Dogmans/h2-fan-duct/output/underside_down/air_path.png

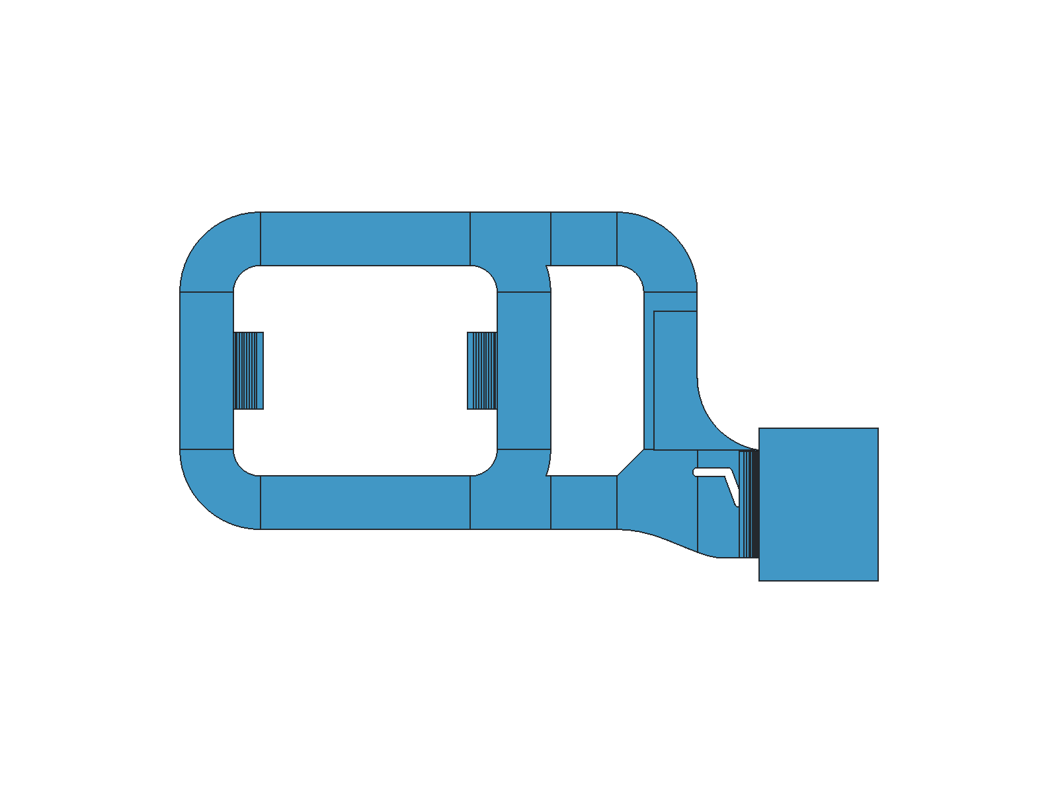
output/underside_down/air_path.png
