Dogmans/h2-fan-duct/output/underside_down/duct.png

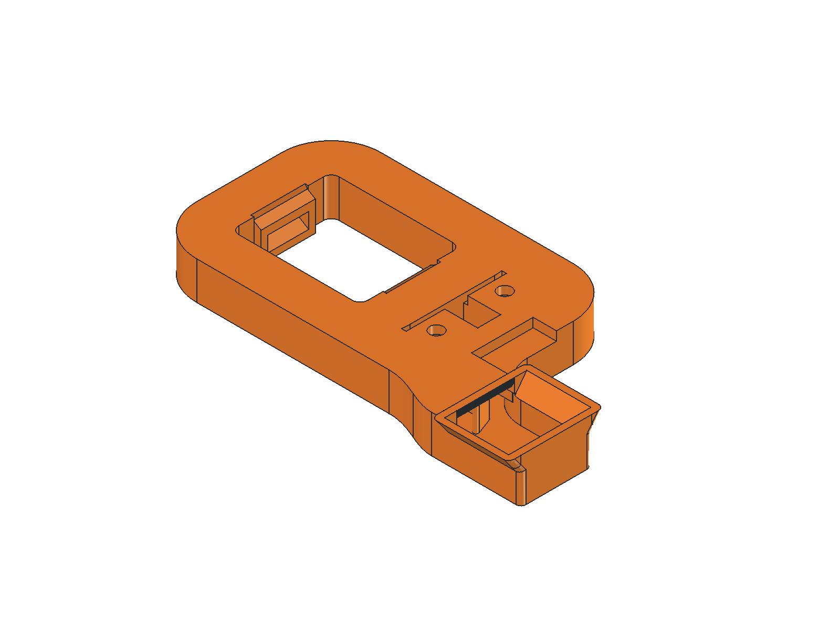
output/underside_down/duct.png
