Dogmans/h2-fan-duct/output/underside_down/duct_bottom.png

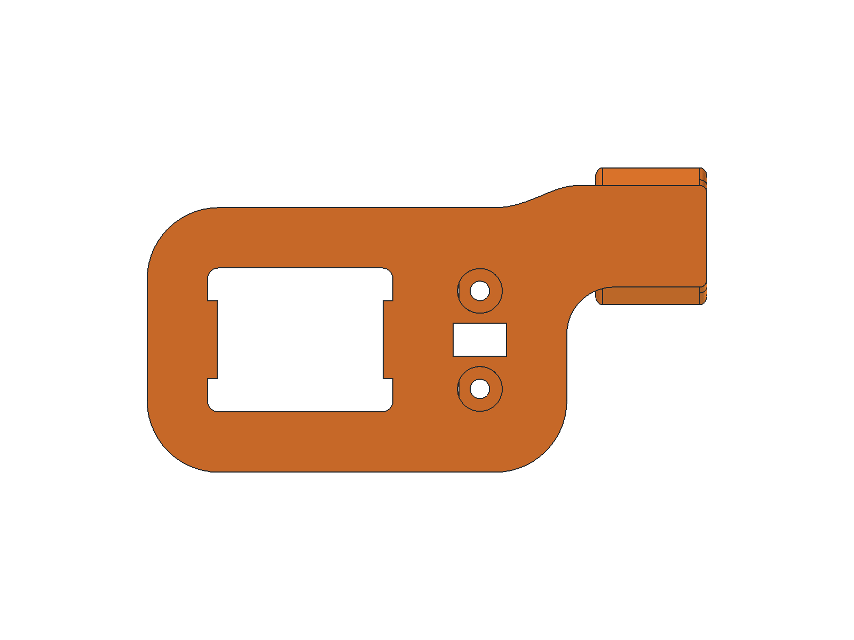
output/underside_down/duct_bottom.png
