Dogmans/h2-fan-duct/output/underside_down/intake_gap.png

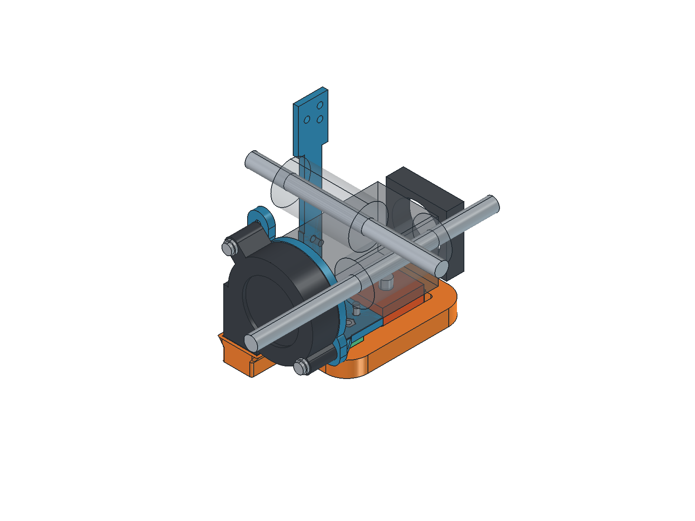
output/underside_down/intake_gap.png
