Dogmans/h2-fan-duct/output/underside_down/underside.png

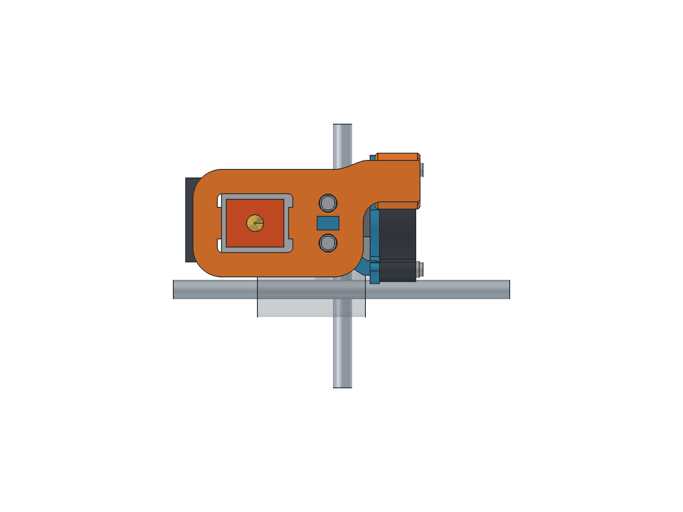
output/underside_down/underside.png
