Dogmans/h2-fan-duct/reference/5015-drawing.png

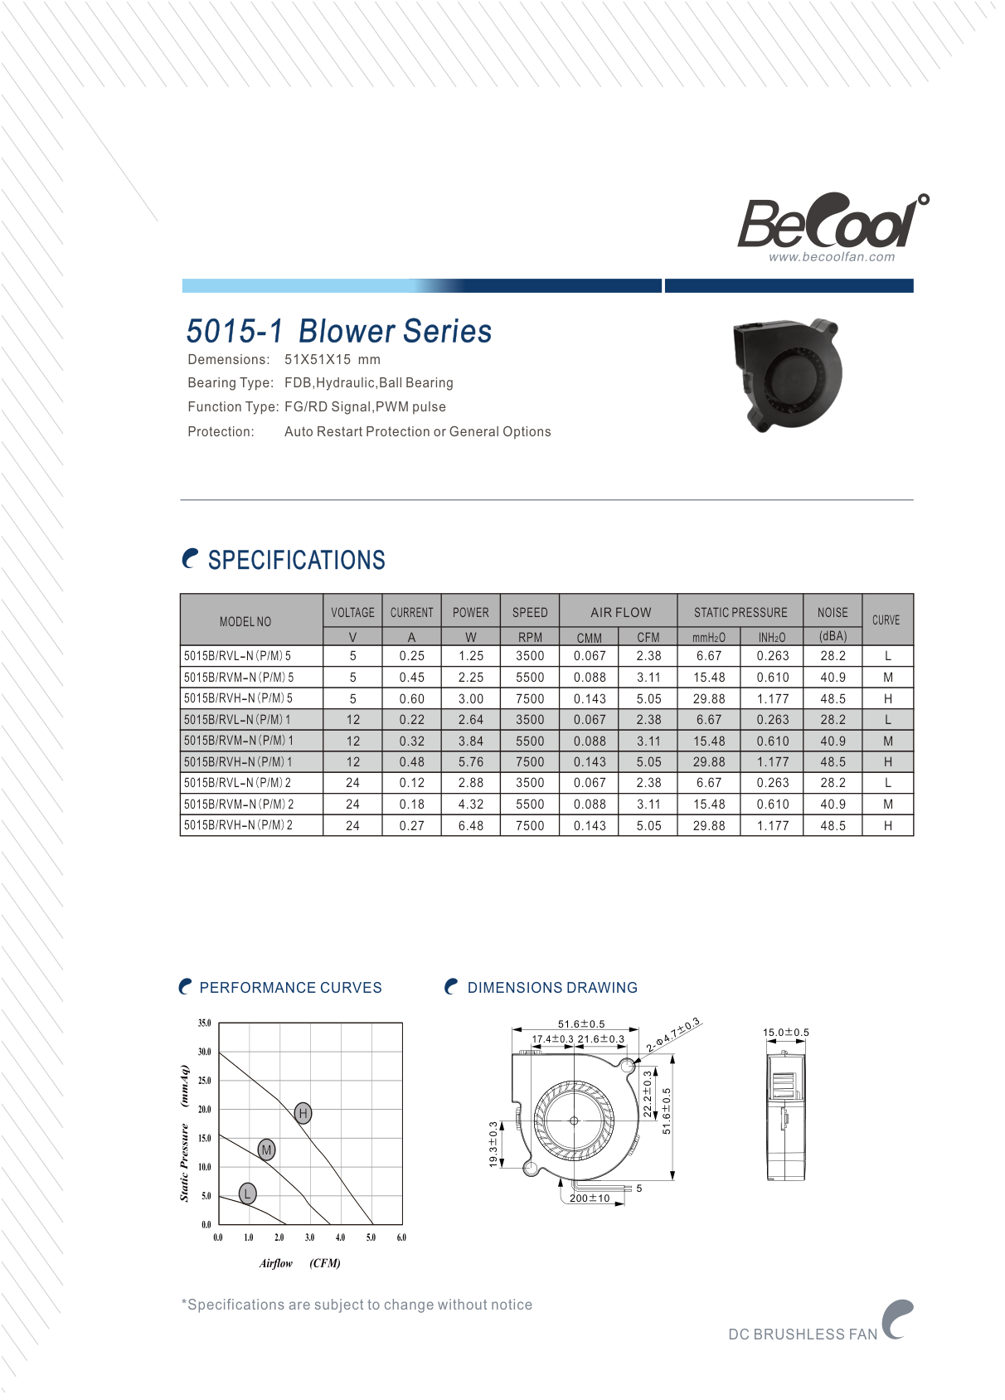
reference/5015-drawing.png
