Dogmans/h2-fan-duct/reference/H2-dimensions.png

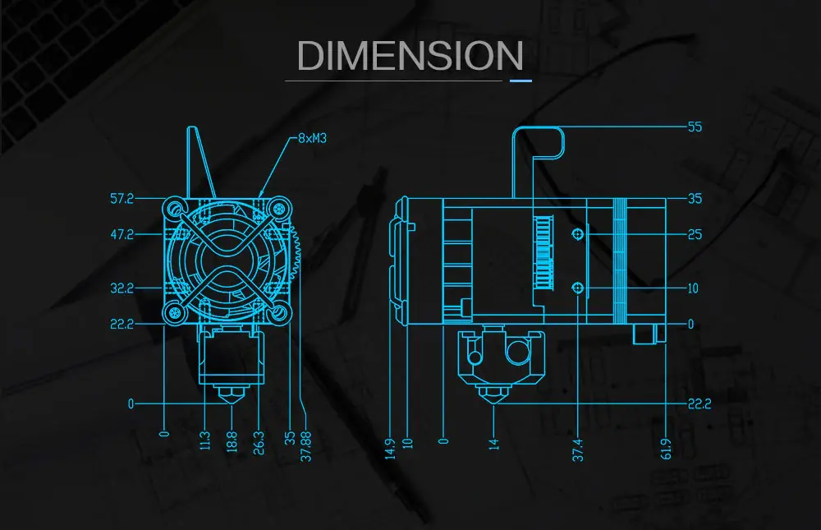
reference/H2-dimensions.png
