Dogmans/h2-fan-duct/reference/H2-page2.png

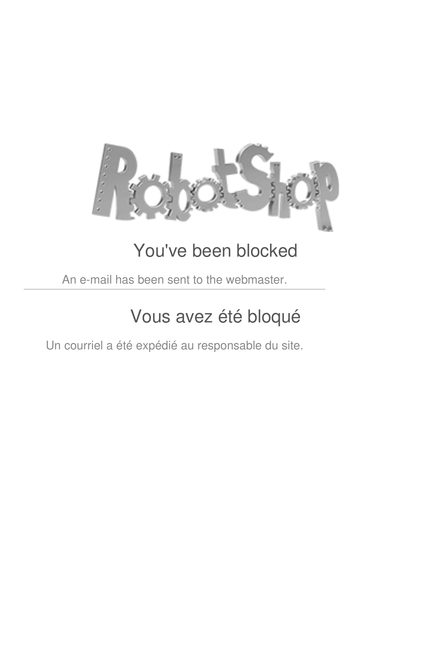
reference/H2-page2.png
