Dogmans/h2-fan-duct/reference/H2-v2-dimensions.jpg

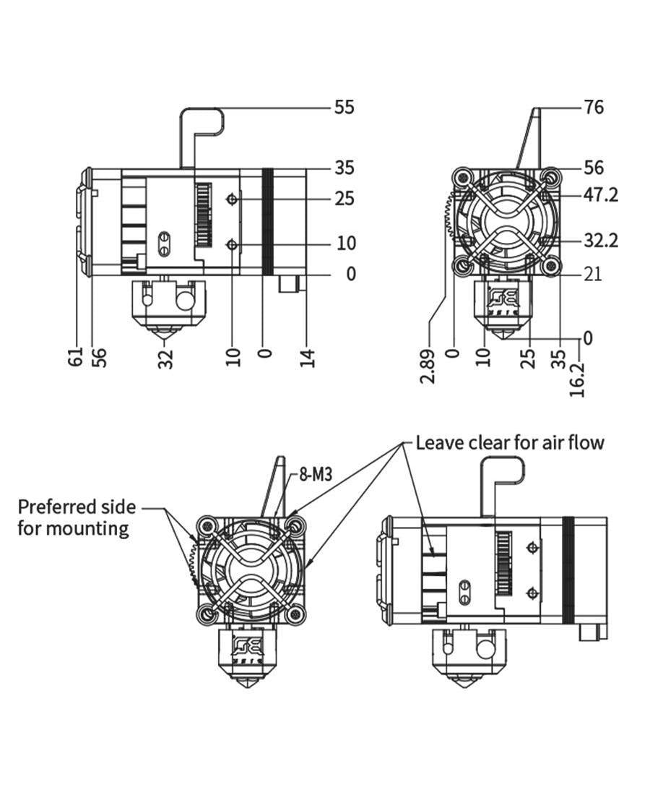
reference/H2-v2-dimensions.jpg
