Dogmans/h2-fan-duct/output/underside_down/duct_assembled.step

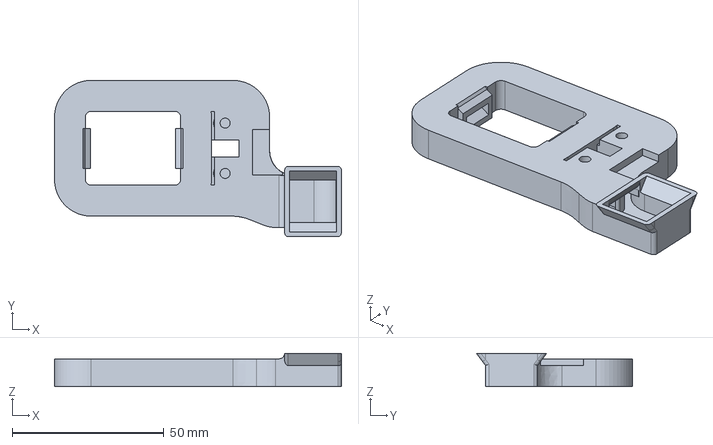
[picture p13: CAD file, 2026-11-11]
output/underside_down/duct_assembled.step
94.7 x 51.5 x 11.0 mm
