Dogmans/h2-fan-duct/output/before_clearance_redesign/duct_assembled.step

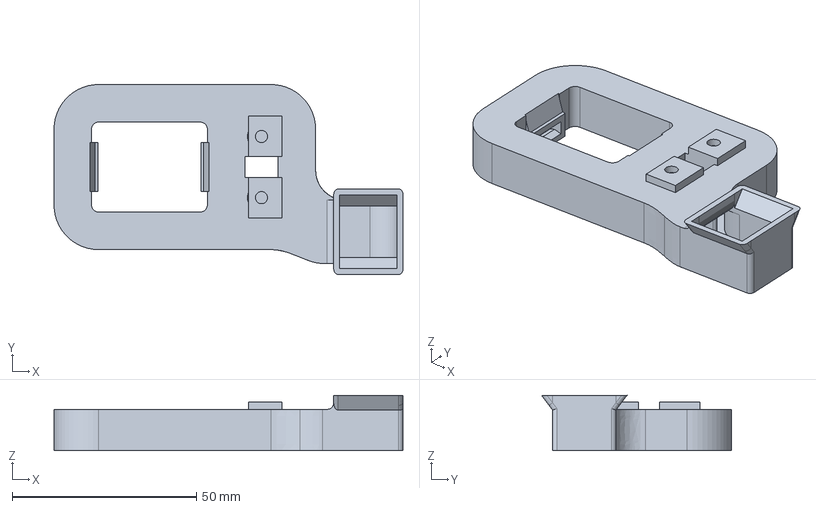
[picture p14: CAD file, 2026-11-08]
output/before_clearance_redesign/duct_assembled.step
94.7 x 51.5 x 15.0 mm
