Dogmans/h2-fan-duct/output/underside_down/printed_assembly.step

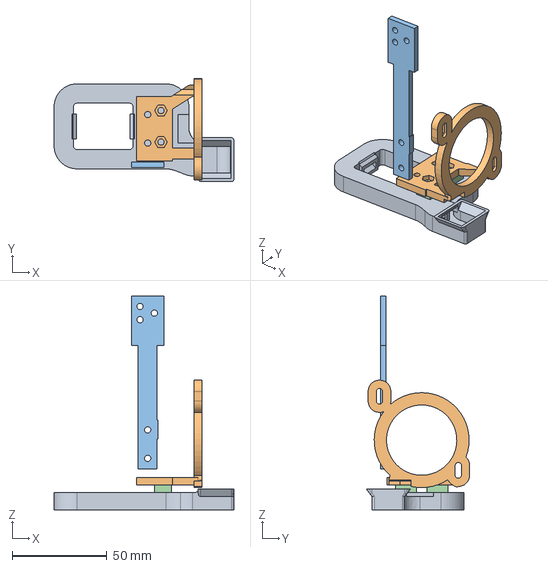
[picture p15: CAD file, 2026-11-11]
output/underside_down/printed_assembly.step
94.7 x 54.5 x 112.7 mm
