Dogmans/h2-fan-duct/output/underside_down/spacer_4mm_assembled.step

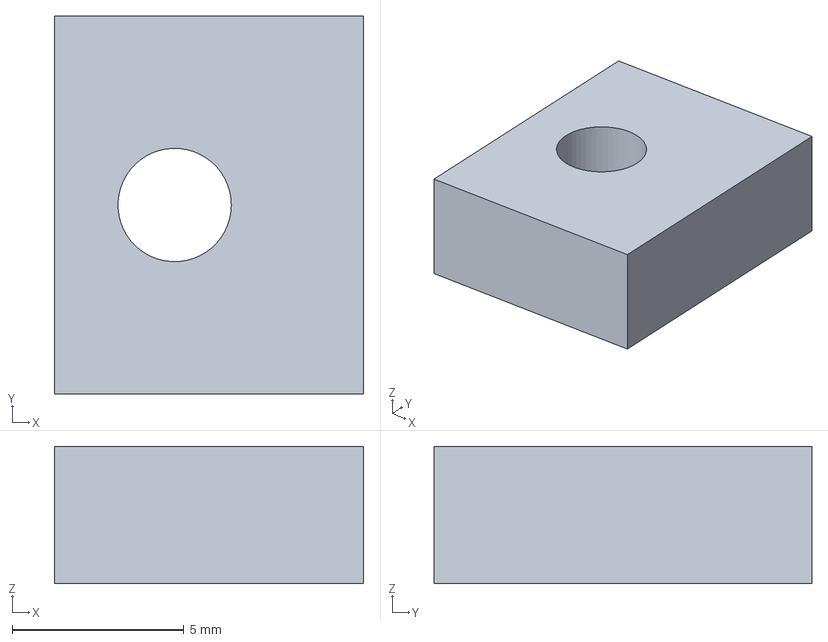
[picture p16: CAD file, 2026-11-08]
output/underside_down/spacer_4mm_assembled.step
9.00 x 11.0 x 4.00 mm
