Dogmans/h2-fan-duct/output/underside_down/chain_plate_assembled.step

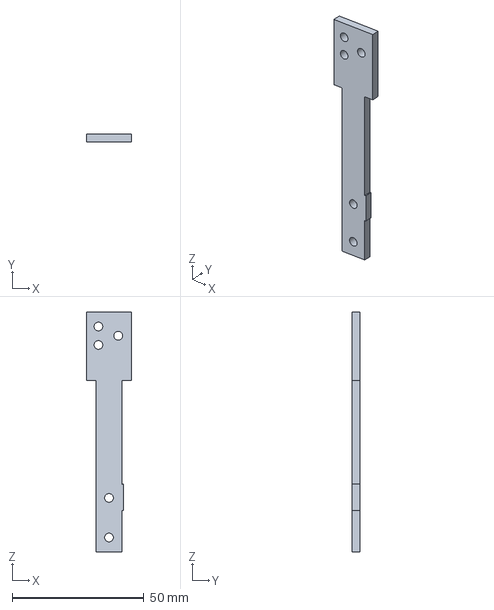
[picture p17: CAD file, 2026-11-08]
output/underside_down/chain_plate_assembled.step
17.0 x 3.00 x 91.0 mm
