Dogmans/h2-fan-duct/output/underside_down/spacer_2mm_assembled.step

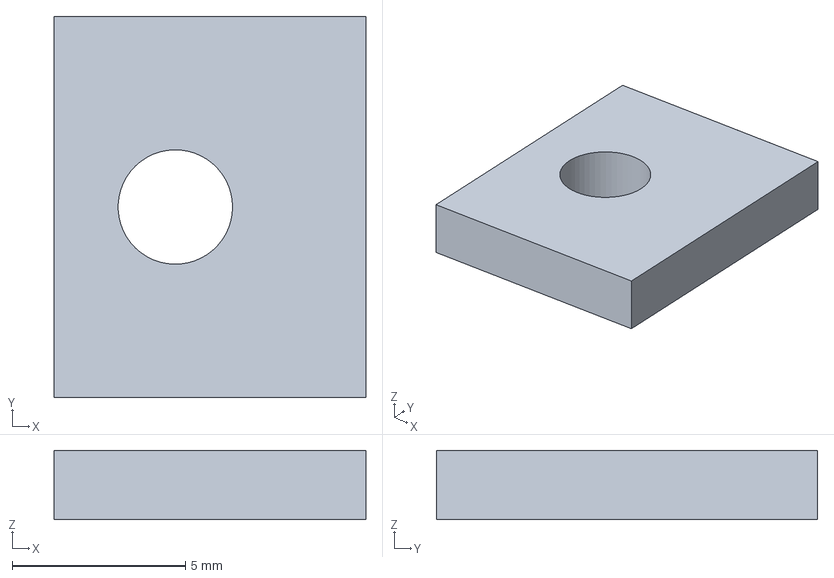
[picture p18: CAD file, 2026-11-08]
output/underside_down/spacer_2mm_assembled.step
9.00 x 11.0 x 2.00 mm
