Dogmans/h2-fan-duct/output/underside_down/fan_bracket_assembled.step

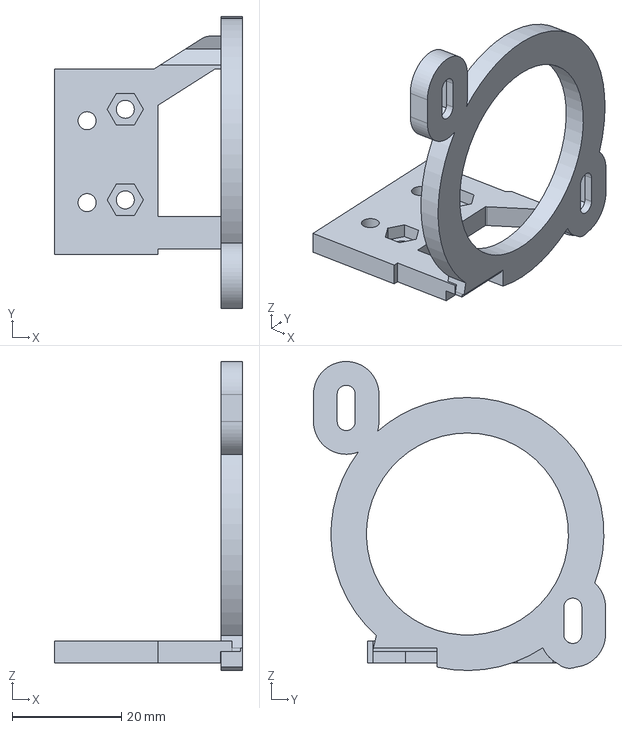
[picture p19: CAD file, 2026-11-08]
output/underside_down/fan_bracket_assembled.step
34.5 x 53.5 x 56.6 mm
