Dogmans/h2-fan-duct/output/before_clearance_redesign/H2_5015_Underside_Down.FCStd

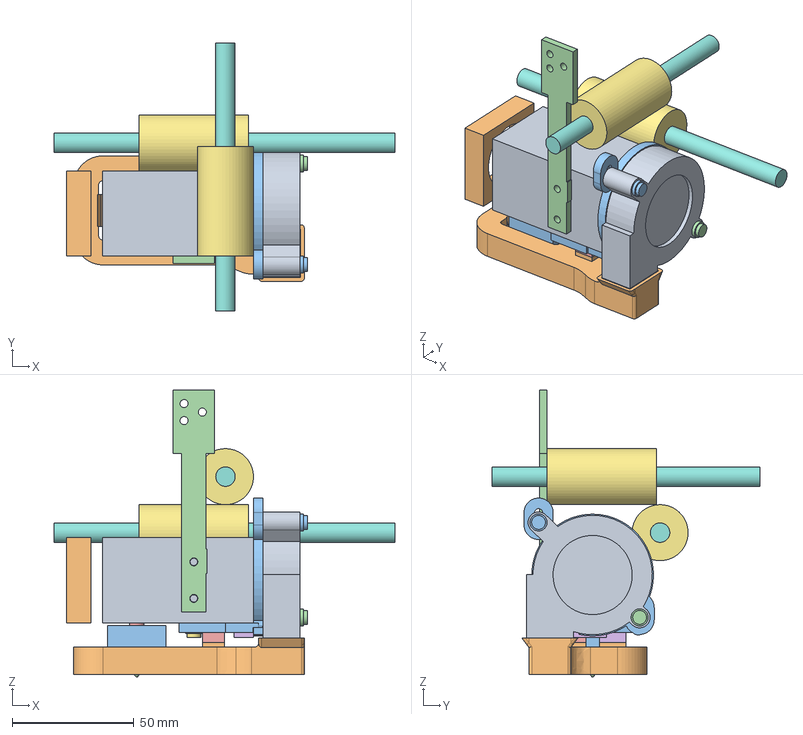
[picture p20: CAD file, 2026-11-11]
output/before_clearance_redesign/H2_5015_Underside_Down.FCStd
140.0 x 110.0 x 117.7 mm
H2 body and motor envelope
KEEP - stock 3510 heatsink cooling fan
Heater / sock keepout - approximate
Nozzle tip datum Z=0
Heatbreak simplified
Motor connector keepout - verify actual plug / wires
Carriage bearing envelopes - verify installed variant
8 mm rods inferred from bearing positions
BUY - 5015 intake outward, discharge down
PRINT - closed twin-feed O duct, underside attachment
PRINT - underside fan bracket, outward intake
PRINT - chain plate
PRINT - 4 mm spacer (nominal duct height)
PRINT - 4 mm spacer (nominal duct height)001
h2_1 - reference hardware
h2_2 - reference hardware
duct_1 - reference hardware
duct_2 - reference hardware
fan_1 - reference hardware
fan_2 - reference hardware
