Dogmans/h2-fan-duct/output/underside_down/fan_bracket_print.stl

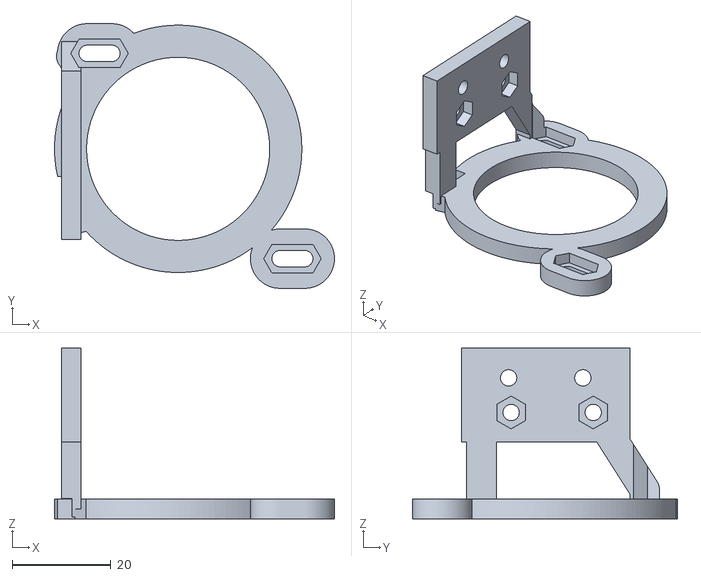
[picture p22: CAD file, 2026-11-08]
output/underside_down/fan_bracket_print.stl
56.6 x 53.5 x 34.5
