Dogmans/h2-fan-duct/(list of files, cad)

Other CAD files:
output/before_clearance_redesign/duct_print.stl
output/underside_down/H2_5015_Underside_Down-PRINT - 4 mm spacer (nominal duct height)001.stl
output/underside_down/H2_5015_Underside_Down-PRINT - underside fan bracket, outward intake.stl
output/underside_down/duct_print.stl
output/underside_down/H2_5015_Underside_Down-PRINT - 4 mm spacer (nominal duct height).stl
output/underside_down/H2_5015_Underside_Down-PRINT - closed twin-feed O duct, underside attachment.stl
output/underside_down/chain_plate_print.stl
output/underside_down/spacer_4mm_print.stl
output/underside_down/spacer_2mm_print.stl
