Dogmans/h2-fan-duct/output/underside_down/chain_plate_print_orientation.png

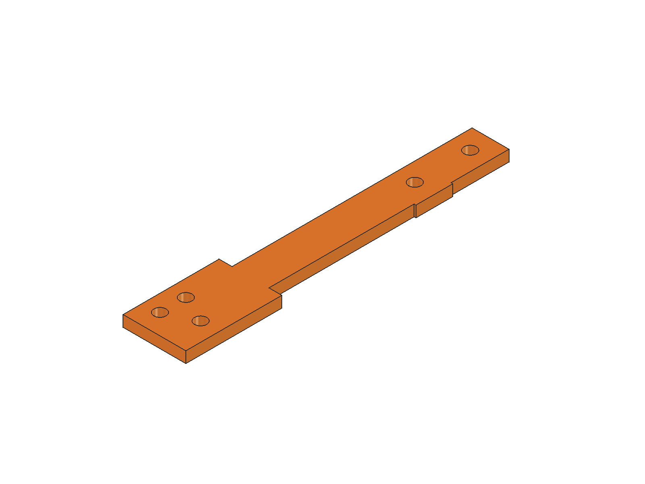
output/underside_down/chain_plate_print_orientation.png
