Dogmans/h2-fan-duct/output/underside_down/fan_bracket_print_orientation.png

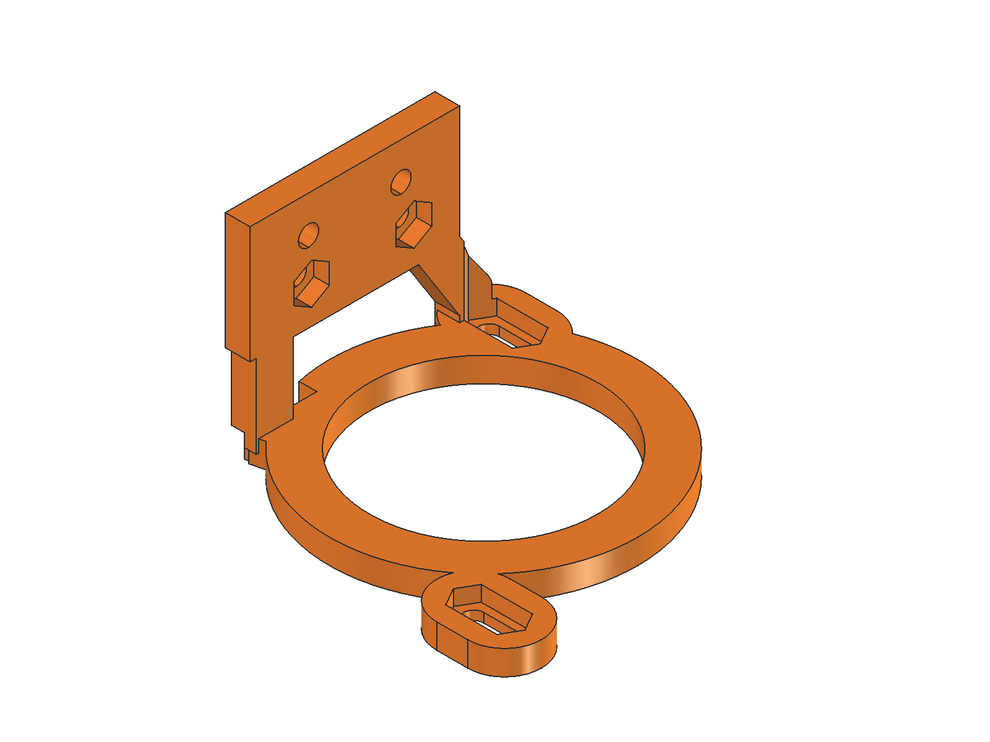
output/underside_down/fan_bracket_print_orientation.png
