Dogmans/h2-fan-duct/output/underside_down/spacer_4mm_print_orientation.png

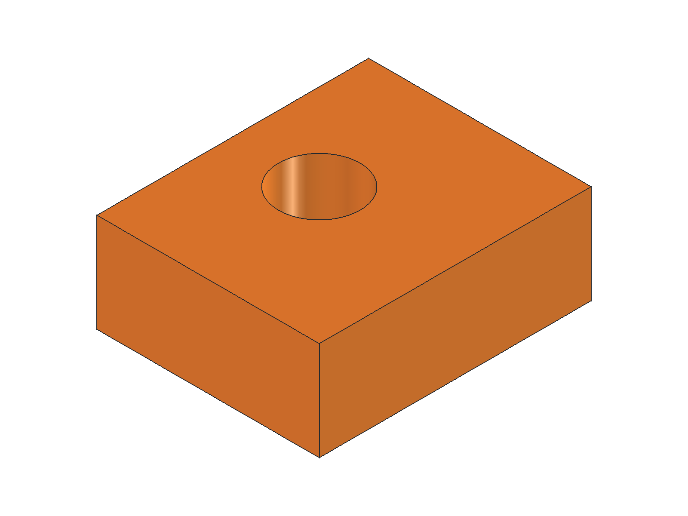
output/underside_down/spacer_4mm_print_orientation.png
