Dogmans/h2-fan-duct/(commit log)

2026-11-05 Initial commit: add BIQU H2 fan duct designs and print files
    [H2_5015_Compact.FCStd, H2_5015_Printable.FCStd, H2_5015_PrintableBracket.FCStd, H2_5015_Right.FCStd, H2_5015_SupportFree.FCStd, adapter_back_assembled.step, adapter_back_print.stl, adapter_front_assembled.step]
2026-11-05 Show installed duct assembly at the top of the README
2026-11-05 Print the lower duct in one piece and retain it with a two-bolt adapter
    [H2_5015_OnePiece.FCStd, adapter_back_assembled.step, adapter_back_print.stl, adapter_front_assembled.step, adapter_front_print.stl, duct_assembled.step, lower_duct_assembled.step, lower_duct_print.stl]
2026-11-05 Slim the one-piece duct and smooth its far-end bend
    [H2_5015_OnePiece.FCStd, adapter_back_assembled.step, adapter_back_print.stl, adapter_front_assembled.step, adapter_front_print.stl, duct_assembled.step, lower_duct_assembled.step, lower_duct_print.stl]
2026-11-05 Print the complete blower-to-nozzle duct as one continuous part
    [H2_5015_Monolithic.FCStd, duct_assembled.step, duct_print.stl]
2026-11-05 Radius the vent and elbow perimeter corners while retaining a flat print base
    [H2_5015_Monolithic.FCStd, duct_assembled.step, duct_print.stl]
2026-11-07 adjustable mount
    [H2_5015_AdjustableMount.FCStd, H2_5015_Monolithic.FCStd, H2_5015_Right.FCStd, h2_5015_right_bracket.step, h2_5015_right_bracket.stl, h2_5015_right_printed_assembly.step]
2026-11-08 Add adjustable underside duct assembly and clear rear fan nut access
    [H2_5015_Underside.FCStd, H2_5015_Underside_Down.FCStd, blend.step, chain_plate_assembled.step, chain_plate_print.stl, duct_assembled.step, duct_print.stl, fan_bracket_assembled.step]
2026-11-08 Keep only underside-down design and refresh README views
    [H2_5015_AdjustableMount.FCStd, H2_5015_Compact.FCStd, H2_5015_Monolithic.FCStd, H2_5015_OnePiece.FCStd, H2_5015_Printable.FCStd, H2_5015_PrintableBracket.FCStd, H2_5015_Right.FCStd, H2_5015_SupportFree.FCStd]
2026-11-11 Raise duct clearance and angle outlets down toward print
    [H2_5015_Underside_Down-PRINT - 4 mm spacer (nominal duct height).stl, H2_5015_Underside_Down-PRINT - 4 mm spacer (nominal duct height)001.stl, H2_5015_Underside_Down-PRINT - closed twin-feed O duct, underside attachment.stl, H2_5015_Underside_Down-PRINT - underside fan bracket, outward intake.stl, H2_5015_Underside_Down.FCStd, duct_assembled.step, duct_print.stl, printed_assembly.step]
